visionspacetec/VST104-Delta/documents/deb_prog_pinout_right.png

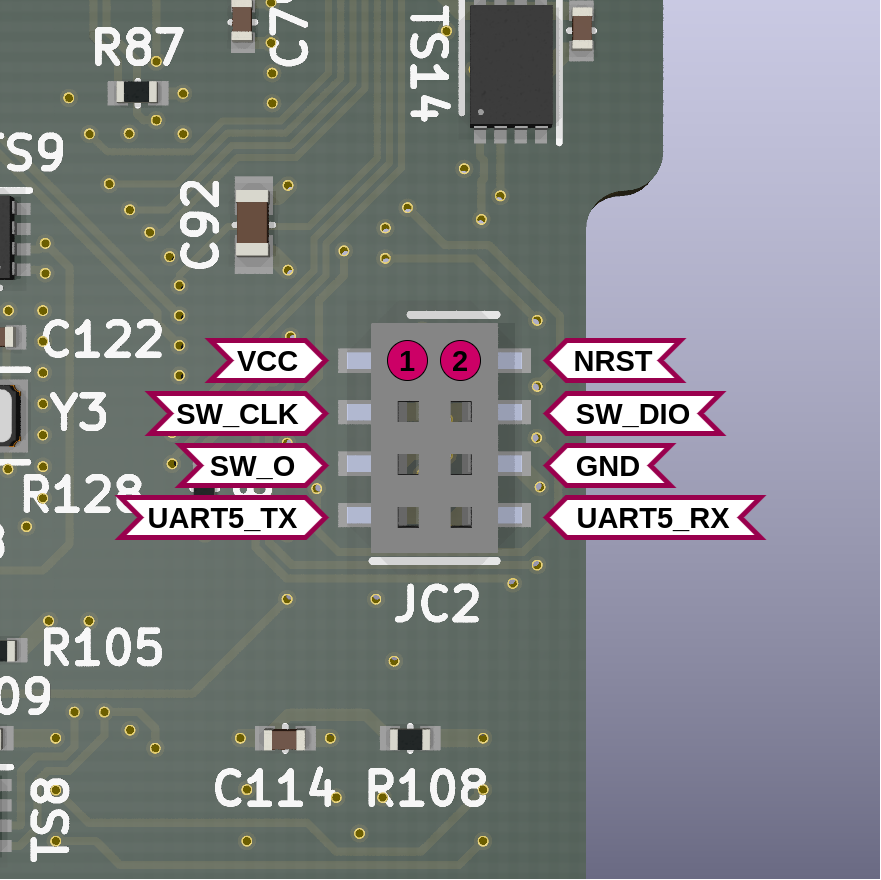
documents/deb_prog_pinout_right.png
