visionspacetec/VST104-Delta/gallery/3Dexport/top_angle.png

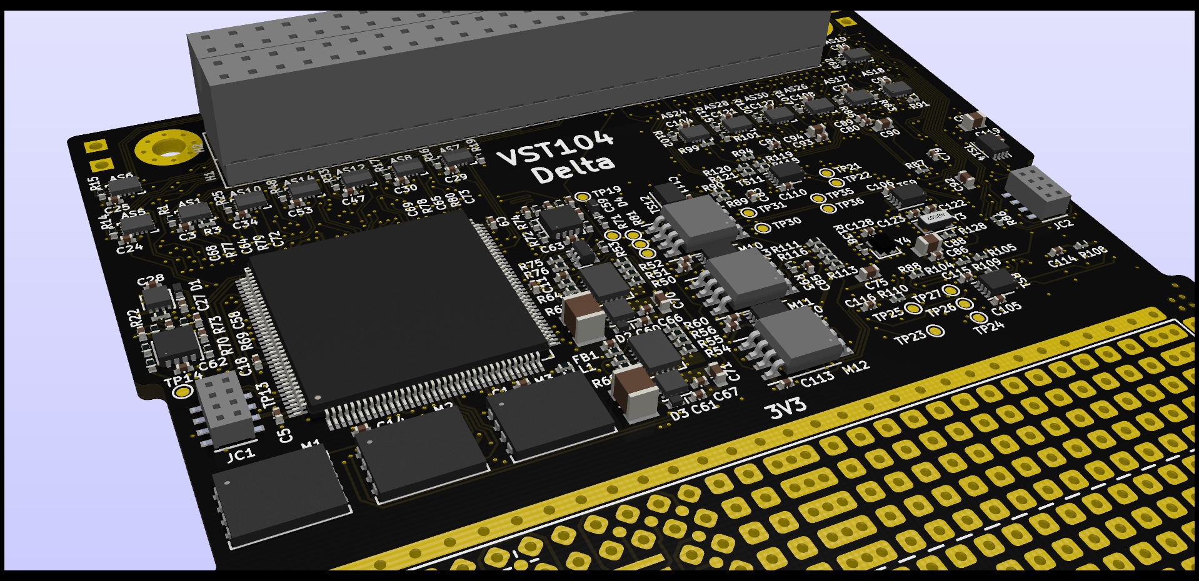
gallery/3Dexport/top_angle.png
