visionspacetec/VST104-Delta/documents/schematic.pdf

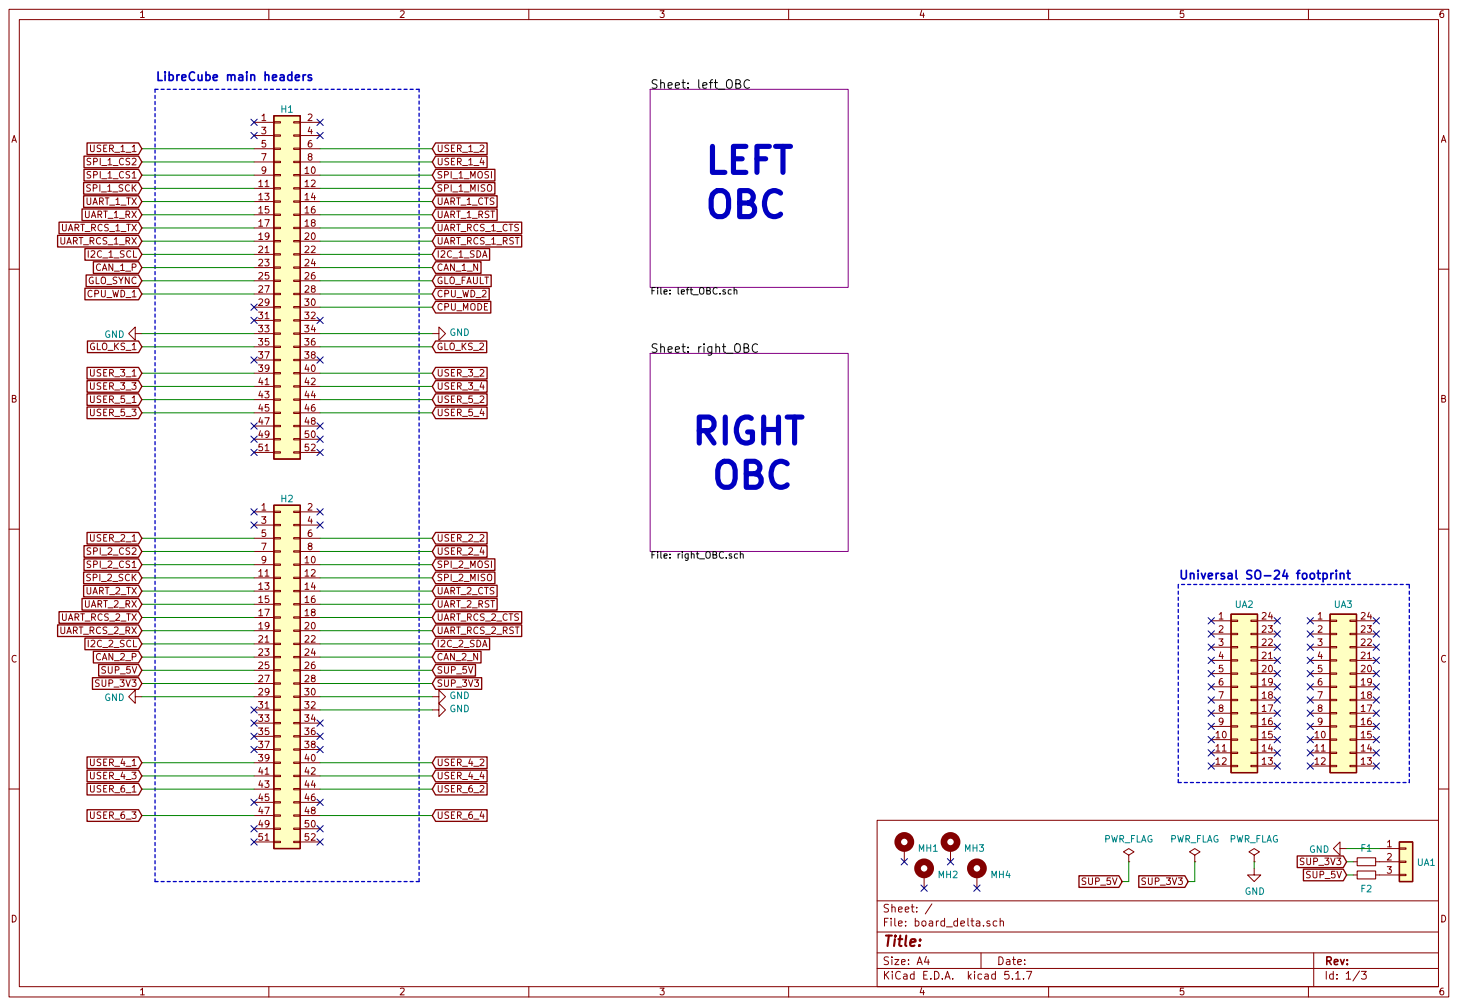
[picture p7: page 1]

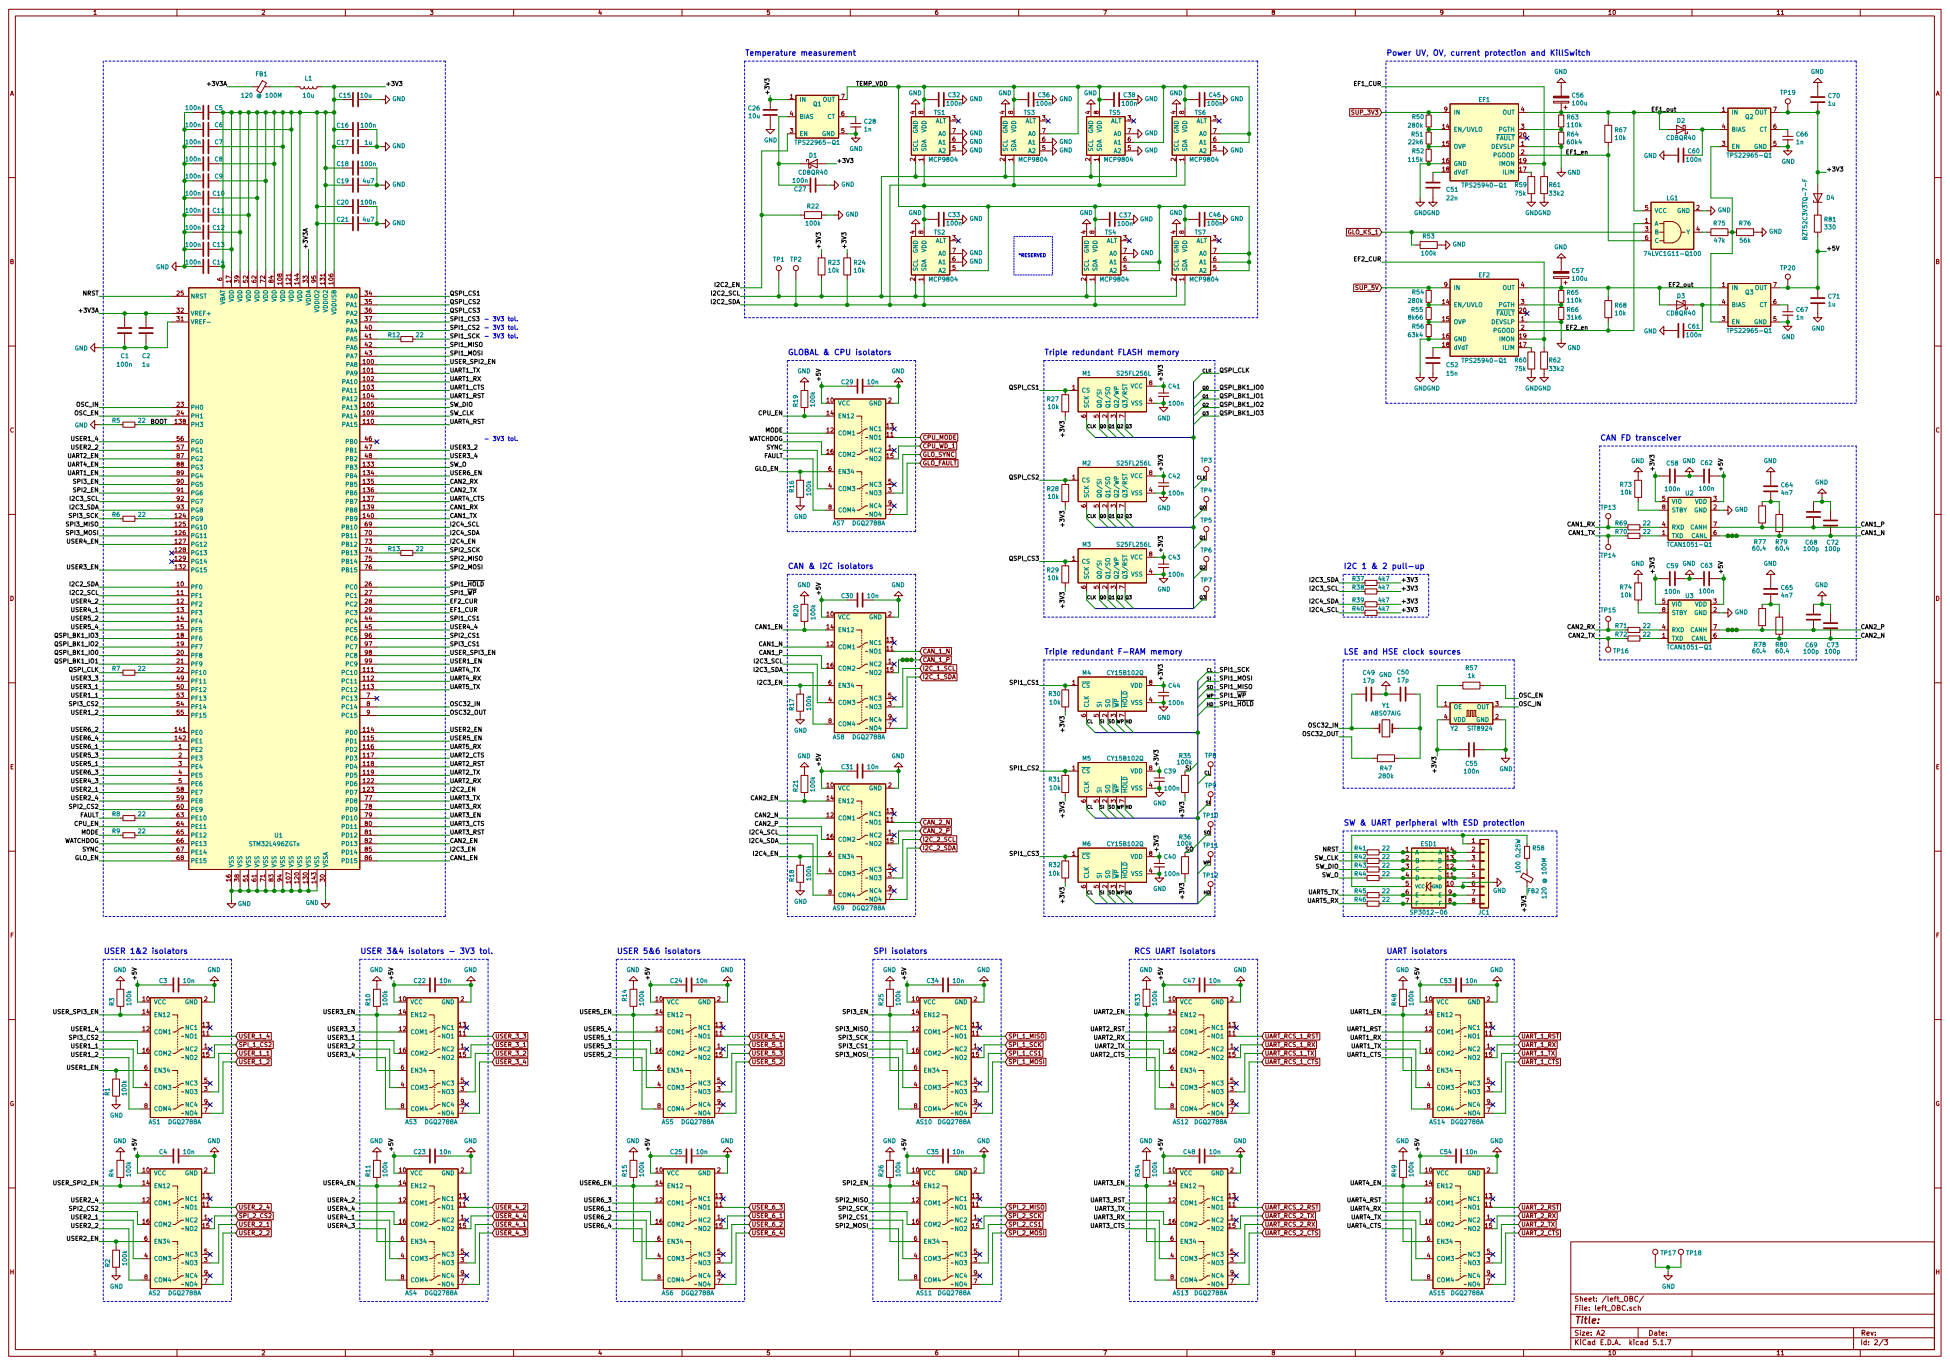
[picture p8: page 2]

Power UV, OV, current protection and KillSwitch

6 VDD 108 VDD 121 VDD 144 VDD 17 VDD 39 VDD 52 VDD 62 VDD 72 VDD 84 VDDA 33 VDDIO2 131 VDDIO2 95 VDDUSB 106 VREF+ 32 VREF- 31 VSS 107 VSS 120 VSS 130 VSS 143 VSS 16 VSS 38 VSS 51 VSS 61 VSS 71 VSS 83 VSS 94 VSSA 30 U1 STM32L496ZGTx

Triple redundant F-RAM memory

LSE and HSE clock sources

SW & UART peripheral with ESD protection

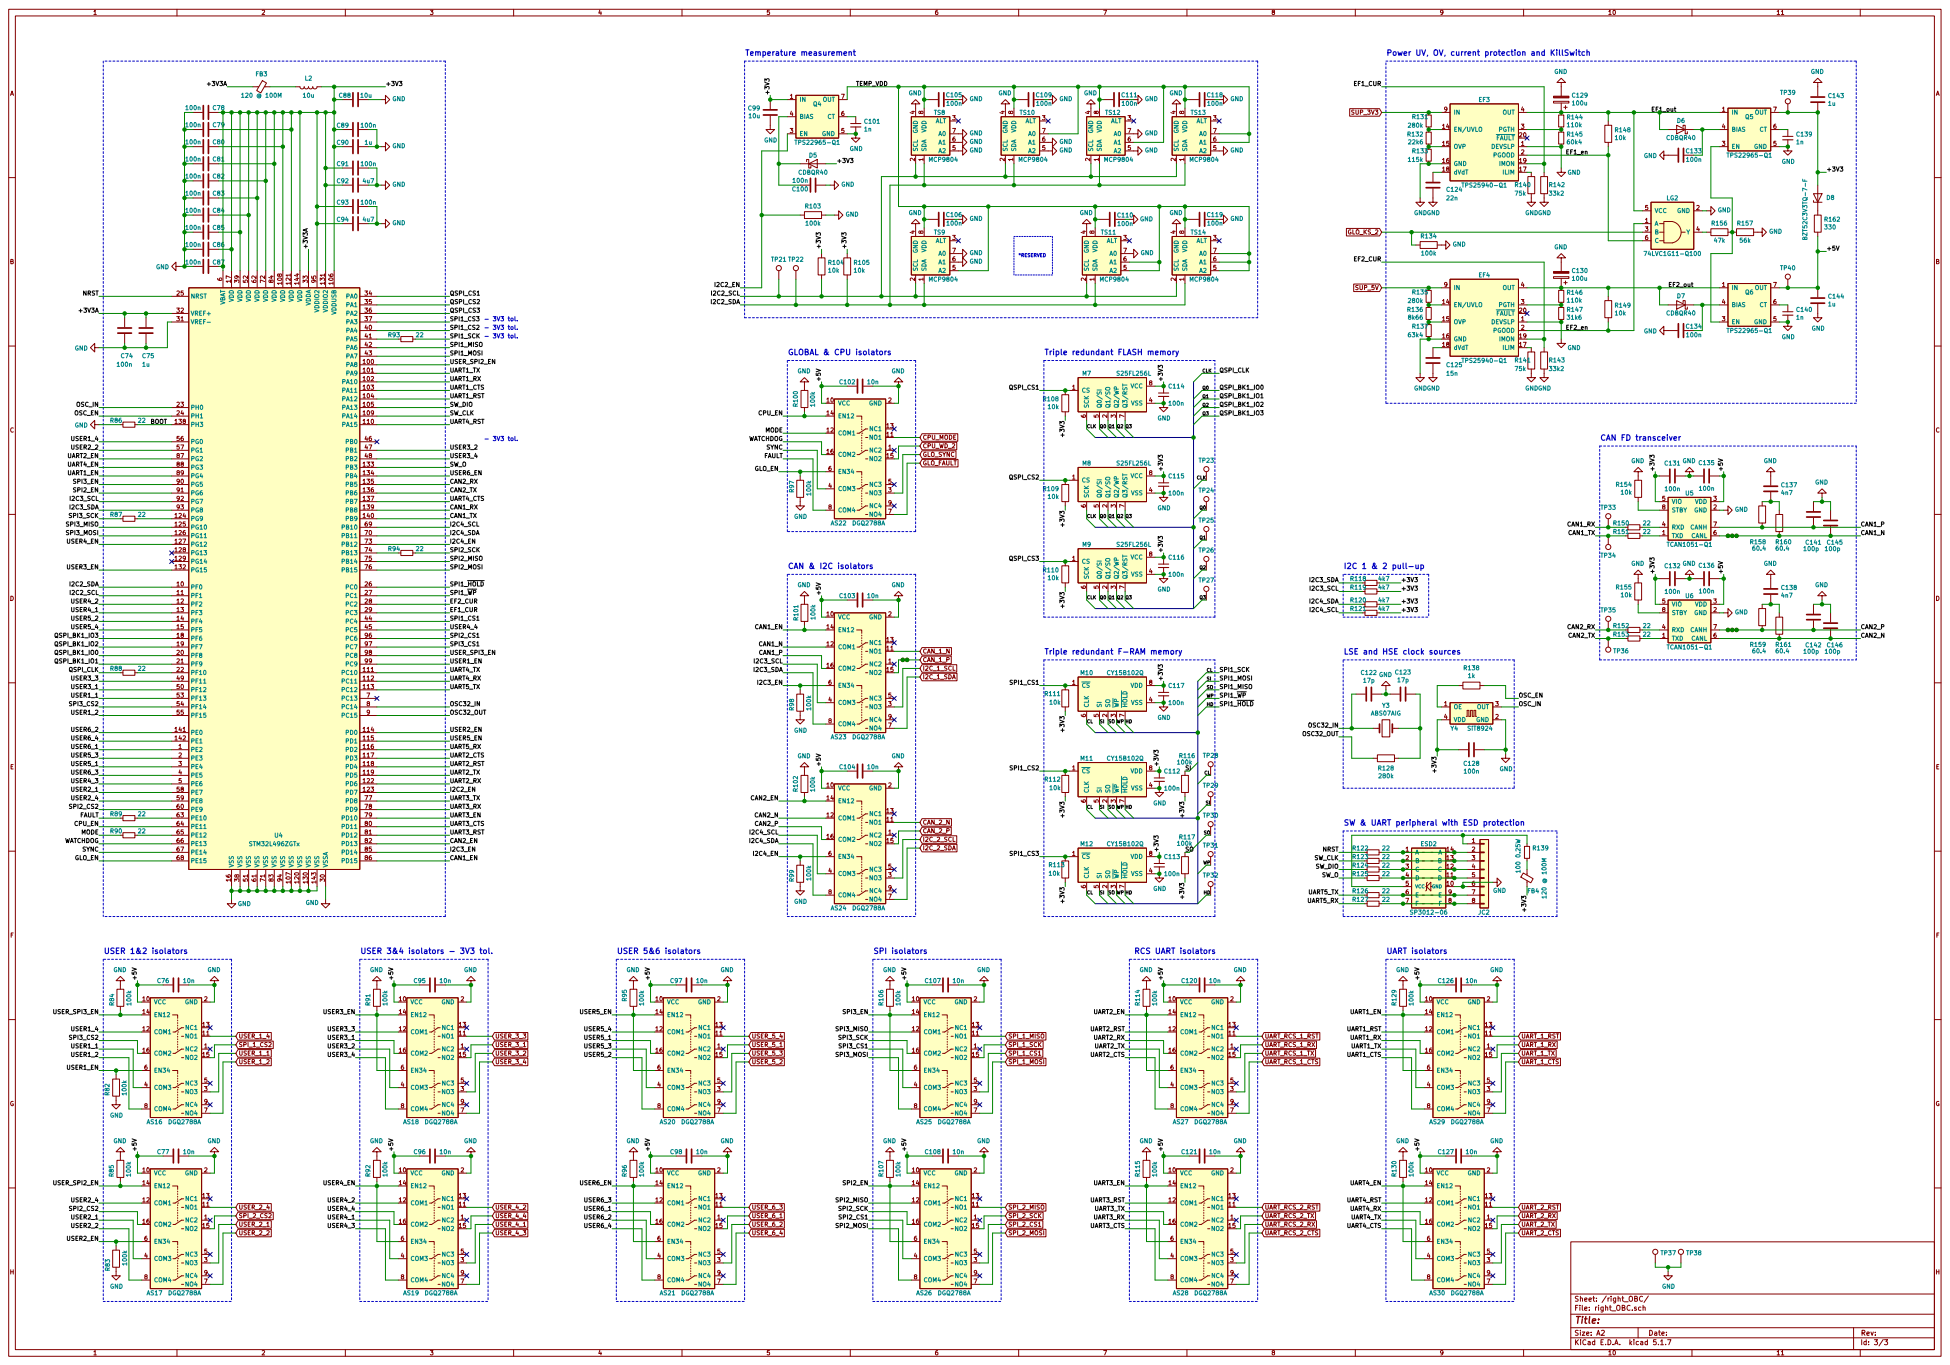
[picture p9: page 3]

Power UV, OV, current protection and KillSwitch

6 VDD 108 VDD 121 VDD 144 VDD 17 VDD 39 VDD 52 VDD 62 VDD 72 VDD 84 VDDA 33 VDDIO2 131 VDDIO2 95 VDDUSB 106 VREF+ 32 VREF- 31 VSS 107 VSS 120 VSS 130 VSS 143 VSS 16 VSS 38 VSS 51 VSS 61 VSS 71 VSS 83 VSS 94 VSSA 30 U4 STM32L496ZGTx

Triple redundant FLASH memory

Triple redundant F-RAM memory

LSE and HSE clock sources

SW & UART peripheral with ESD protection
