visionspacetec/VST104-Delta/board_delta.sch

## KiCad design board_delta.sch (2020-11-25)

Schematic: board_delta.sch

Parts:
F1, F2: R_Small; R_SMD_1206
H1, H2: Conn_02x26_Odd_Even; ESQ-126-39-x-D
MH1, MH2, MH3, MH4: MountingHole_Pad; MountingHole_3.2mm_M3_Pad_Via
UA1: Conn_01x03; PC104_universal_FPGA
UA2, UA3: Conn_02x12_Counter_Clockwise; PC104_SO-24_universal

Notes on the sheet:
LibreCube main headers
Universal SO-24 footprint
LEFT OBC
RIGHT OBC
