visionspacetec/VST104-Delta/left_OBC.sch

## KiCad design left_OBC.sch (2020-11-25)

Schematic: left_OBC.sch

Parts:
AS1, AS2, AS3, AS4, AS5, AS6, AS7, AS8, AS9, AS10, AS11, AS12, AS13, AS14, AS15: DGQ2788A; mini_QFN-16-1.8x2.6mm
C1, C5, C6, C7, C8, C9, C10, C11, C12, C13, C14, C16, C18, C20, C27, C32, C33, C36, C37, C38, C39, C40, C41, C42, C43, C44, C45, C46, C55, C58, C59, C60, C61, C62, C63: 100n; C_SMD_0402
C2, C17, C70, C71: 1u; C_SMD_0603
C3, C4, C22, C23, C24, C25, C29, C30, C31, C34, C35, C47, C48, C53, C54: 10n; C_SMD_0402
C15, C26: 10u; C_SMD_0805
C19, C21: 4u7; C_SMD_0603
C28, C66, C67: 1n; C_SMD_0402
C49, C50: 17p; C_SMD_0402
C51: 22n; C_SMD_0402
C52: 15n; C_SMD_0402
C56, C57: 100u; C_SMD_1210
C64, C65: 4n7; C_SMD_0402
C68, C69, C72, C73: 100p; C_SMD_0402
D1, D2, D3: CDBQR40; D_SMD_0402
D4: BZT52C3V3TQ-7-F; D_SOD-523_1.2x0.8mm
EF1, EF2: TPS25940-Q1; WQFN-20_4.0x3.0mm_EPV
ESD1: SP3012-06; uDFN-14_3.5x1.35mm
FB1, FB2: 120 @ 100M; R_SMD_0402
JC1: SW&UART; CLP-104-02-x-D
L1: 10u; L_SMD_0402
LG1: 74LVC1G11-Q100; SOT-363_TSSOP-6_2.0x1.25mm
M1, M2, M3: S25FL256L; WSON-8_6.0x8.0mm_EP
M4, M5, M6: CY15B102Q; SOIC-8_208_5.23x5.23mm
Q1, Q2, Q3: TPS22965-Q1; WSON-8_2.0x2.0mm_EPV
R1, R2, R3, R4, R10, R11, R14, R15, R16, R17, R18, R19, R20, R21, R22, R25, R26, R33, R34, R35, R36, R48, R49, R53: 100k; R_SMD_0402
R5, R6, R7, R8, R9, R12, R13, R41, R42, R43, R44, R45, R46, R69, R70, R71, R72: 22; R_SMD_0402
R23, R24, R27, R28, R29, R30, R31, R32, R67, R68, R73, R74: 10k; R_SMD_0402
R37, R38, R39, R40: 4k7; R_SMD_0402
R47, R50, R54: 280k; R_SMD_0402
R51: 22k6; R_SMD_0402
R52: 115k; R_SMD_0402
R55: 8k66; R_SMD_0402
R56: 63k4; R_SMD_0402
R57: 1k; R_SMD_0402
R58: 100 0.25W; R_SMD_0603
R59, R60: 75k; R_SMD_0402
R61, R62: 33k2; R_SMD_0402
R63, R65: 110k; R_SMD_0402
R64: 60k4; R_SMD_0402
R66: 31k6; R_SMD_0402
R75: 47k; R_SMD_0402
R76: 56k; R_SMD_0402
R77, R78, R79, R80: 60.4; R_SMD_0402
R81: 330; R_SMD_0402
TP1, TP2, TP3, TP4, TP5, TP6, TP7, TP8, TP9, TP10, TP11, TP12, TP13, TP14, TP15, TP16, TP19, TP20: test_point; scope_PAD_1mm
TP17, TP18: GND; scope_GND
TRC1, TRC2, TRC3: trace_0.173mm; trace_arc_0.173mm
TRC4, TRC5, TRC6, TRC7, TRC8, TRC9: trace_0.2mm; trace_arc_0.2mm
TS1, TS2, TS3, TS4, TS5, TS6, TS7: MCP9804; DFN-8_3.0x2.0mm_EP
U1: STM32L496ZGTx; LQFP-144_20x20mm_P0.5mm
U2, U3: TCAN1051-Q1; VSON-8_3.0x3.0mm_EPV
Y1: ABS07AIG; LSE_3.2x1.5mm
Y2: SiT8924; HSE_2.0x1.6mm

Notes on the sheet:
SPI isolators
RCS UART isolators
UART isolators
LSE and HSE clock sources
SW & UART peripheral with ESD protection
Power UV, OV, current protection and KillSwitch
Triple redundant F-RAM memory
Triple redundant FLASH memory
I2C 1 & 2 pull-up
CAN FD transceiver
GLOBAL & CPU isolators
USER 1&2 isolators
USER 3&4 isolators - 3V3 tol.
USER 5&6 isolators
CAN & I2C isolators
*RESERVED
Temperature measurement
- 3V3 tol.
