visionspacetec/VST104-Delta/(commit log)

2020-11-25 sync with library
    [board_delta.sch, left_OBC.sch, right_OBC.sch]
2020-11-25 pinout doc. update
    [board_delta.sch, header_pinout.ods]
